datanews/harlem-heat/images/finding_sd_library_files.png

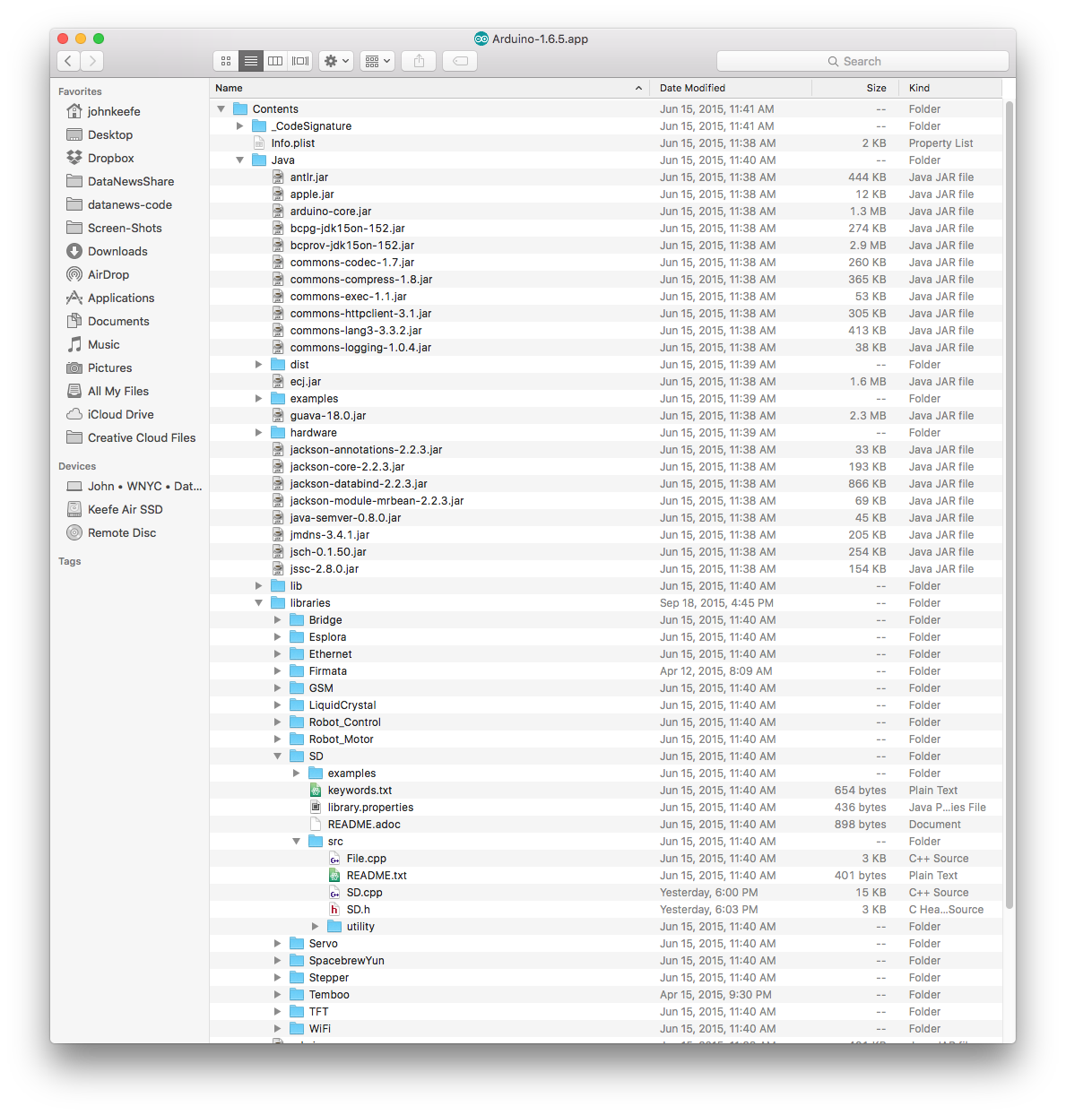
images/finding_sd_library_files.png
