datanews/harlem-heat/images/harlem_heat_aa_Credit-JohnKeefe-WNYC.JPG

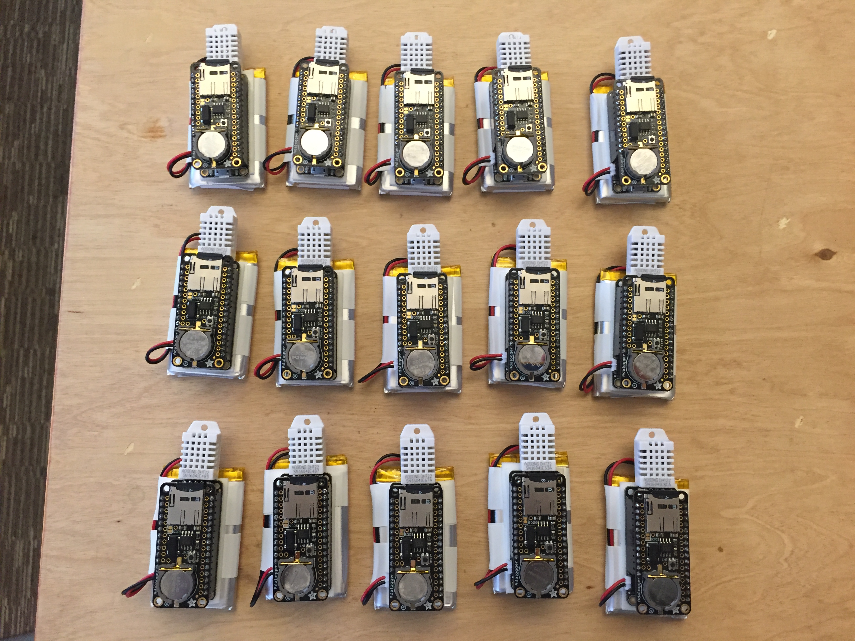
images/harlem_heat_aa_Credit-JohnKeefe-WNYC.JPG
