datanews/harlem-heat/images/harlem_heat_ab_Credit-SarahGonzalez-WNYC.JPG

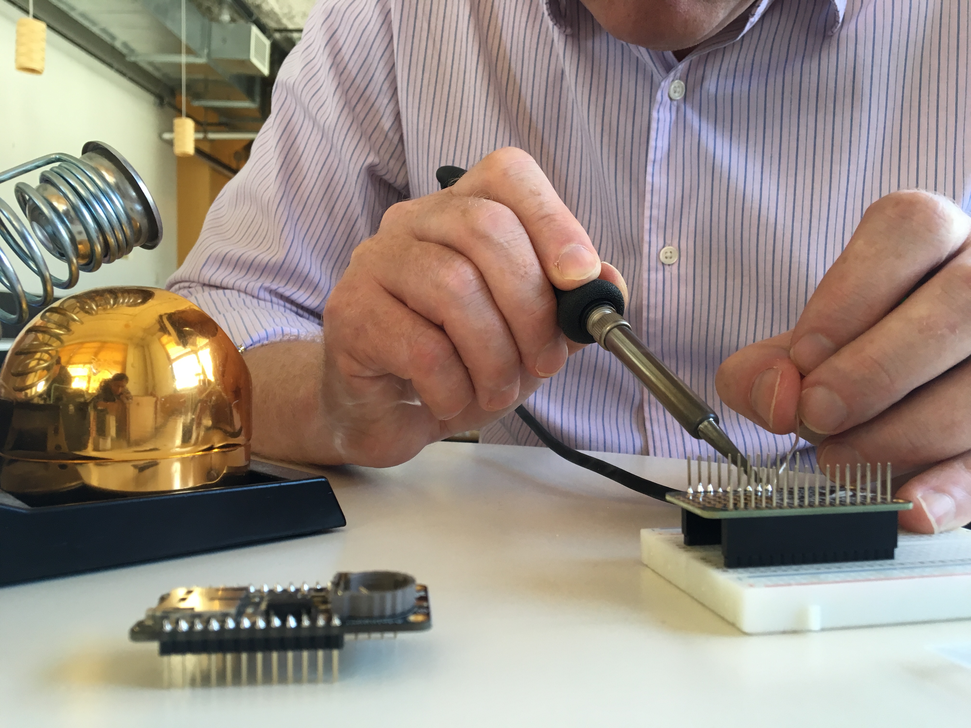
images/harlem_heat_ab_Credit-SarahGonzalez-WNYC.JPG
