datanews/harlem-heat/images/harlem_heat_ac_Credit-SarahGonzalez-WNYC.JPG

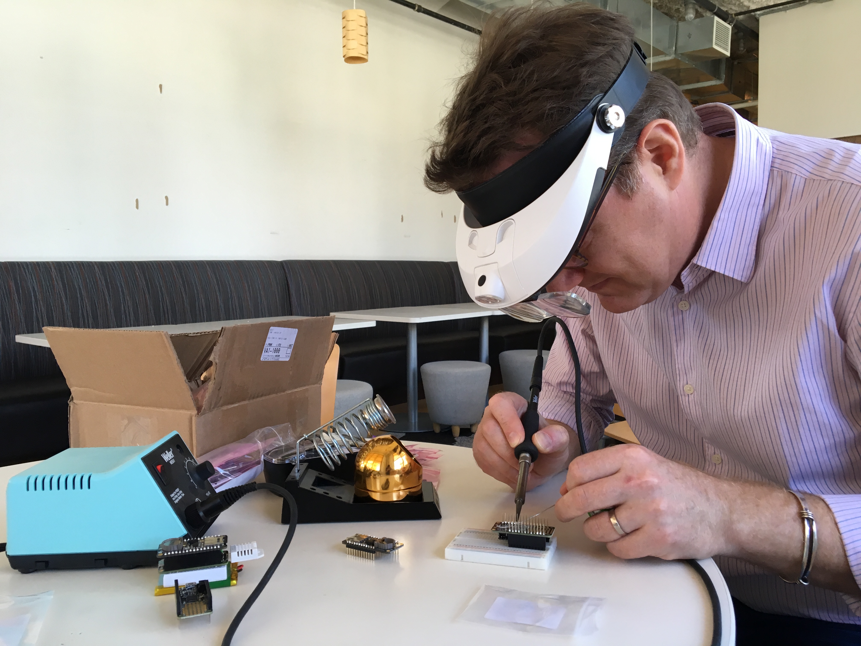
images/harlem_heat_ac_Credit-SarahGonzalez-WNYC.JPG
