datanews/harlem-heat/images/harlem_heat_ad_Credit-SarahGonzalez-WNYC.JPG

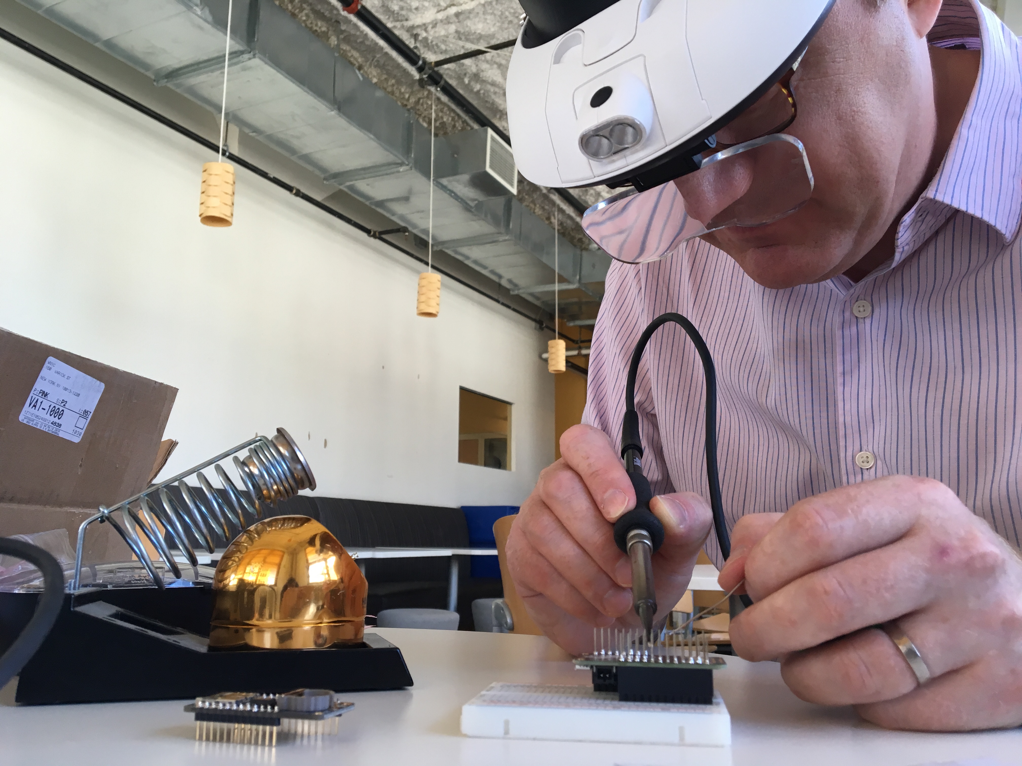
images/harlem_heat_ad_Credit-SarahGonzalez-WNYC.JPG
