datanews/harlem-heat/images/harlem_heat_ba_Credit-JohnKeefe-WNYC.jpg

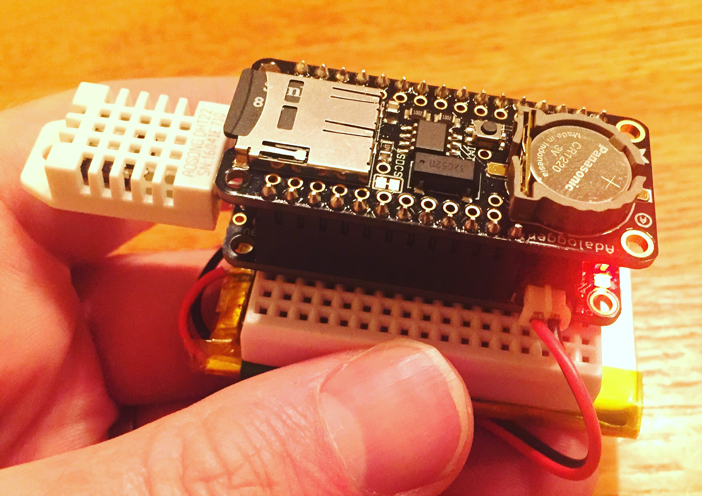
images/harlem_heat_ba_Credit-JohnKeefe-WNYC.jpg
