datanews/harlem-heat/images/harlem_heat_bb_Credit-JohnKeefe-WNYC.JPG

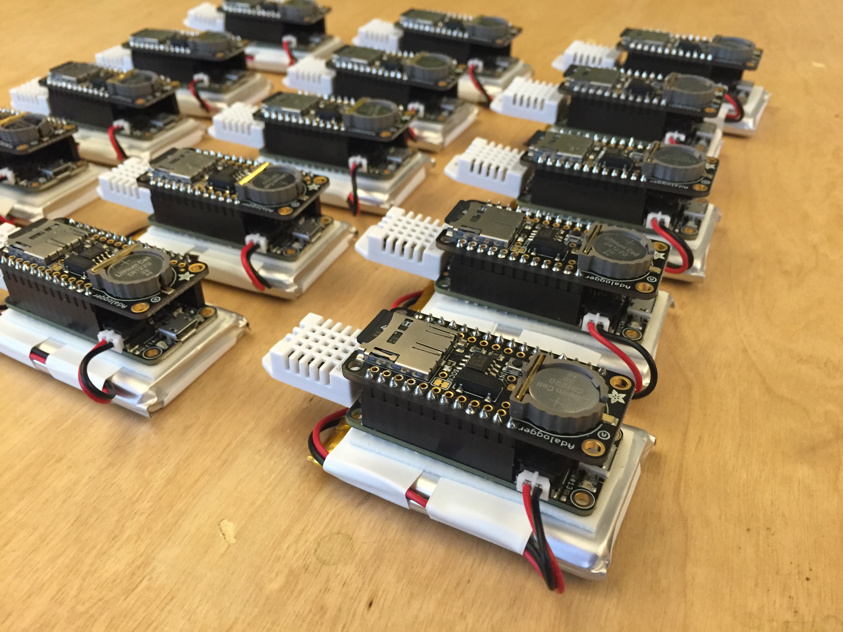
images/harlem_heat_bb_Credit-JohnKeefe-WNYC.JPG
