datanews/harlem-heat/images/harlem_heat_bc_Credit-JohnKeefe-WNYC.JPG

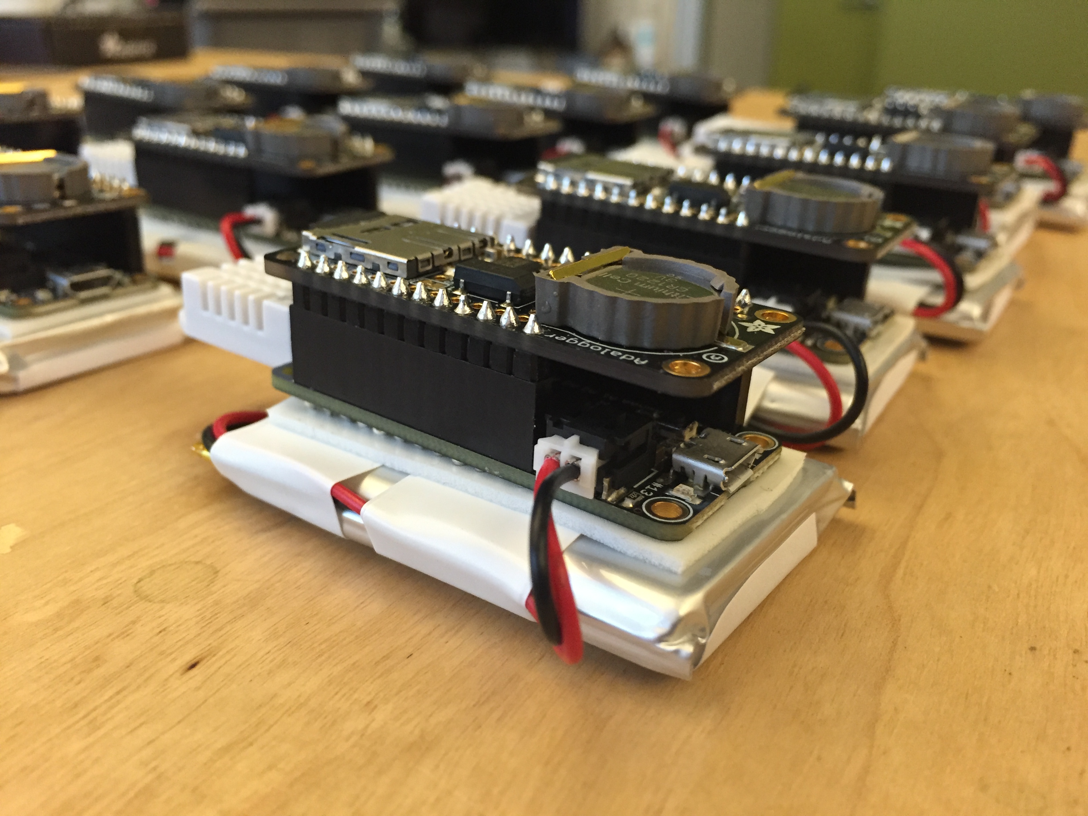
images/harlem_heat_bc_Credit-JohnKeefe-WNYC.JPG
