datanews/harlem-heat/images/Photo Jul 05, 4 11 50 PM.jpg

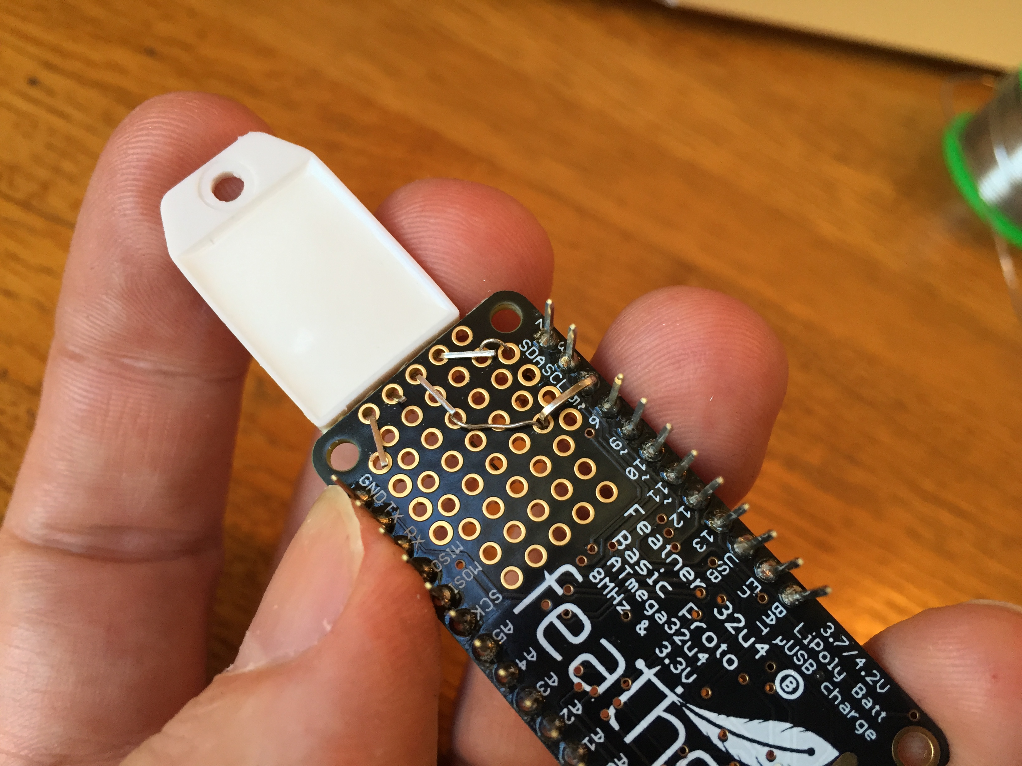
images/Photo Jul 05, 4 11 50 PM.jpg
